birkelbot/Lockout/README.md

# BirkelBot Battlebot Repo
This repository is for the code related to Matt Birkel's Battlebot for the Combotics competition held annually at the University of Illinois at Urbana Champaign

### Folder Structure
* Robot - This is robot side code. For now this should largely be arduino code for the arduino on board the robot.
* DriverStation - This is the operator side code. This is the code that runs on a driverstation computer.
* Arduino_Calibration_Stuff - This is a folder for a tool to use the arduino to calibrate ESC's

### Dependencies
The Robot code is written for an Arduino Pro Mini. As such the Arduino IDE is required to compile and upload the Arduino-side code. The Arduino IDE offers a variety of Libraries for use. This project utilizes

* Encoder by Paul Stoffregen (version 1.4.1)
* PID by Brett Beauregard (version 1.2.0)

To install these libraries

- Go to 'Sketch' -> 'Include Library' -> 'Manage Libraries...'
- Search '<package-name>'
- Install '<package-name>'
