birkelbot/Lockout/PCB_files/Dumptruck2020.brd

## EAGLE design PCB_files/Dumptruck2020.brd (2020-02-21)

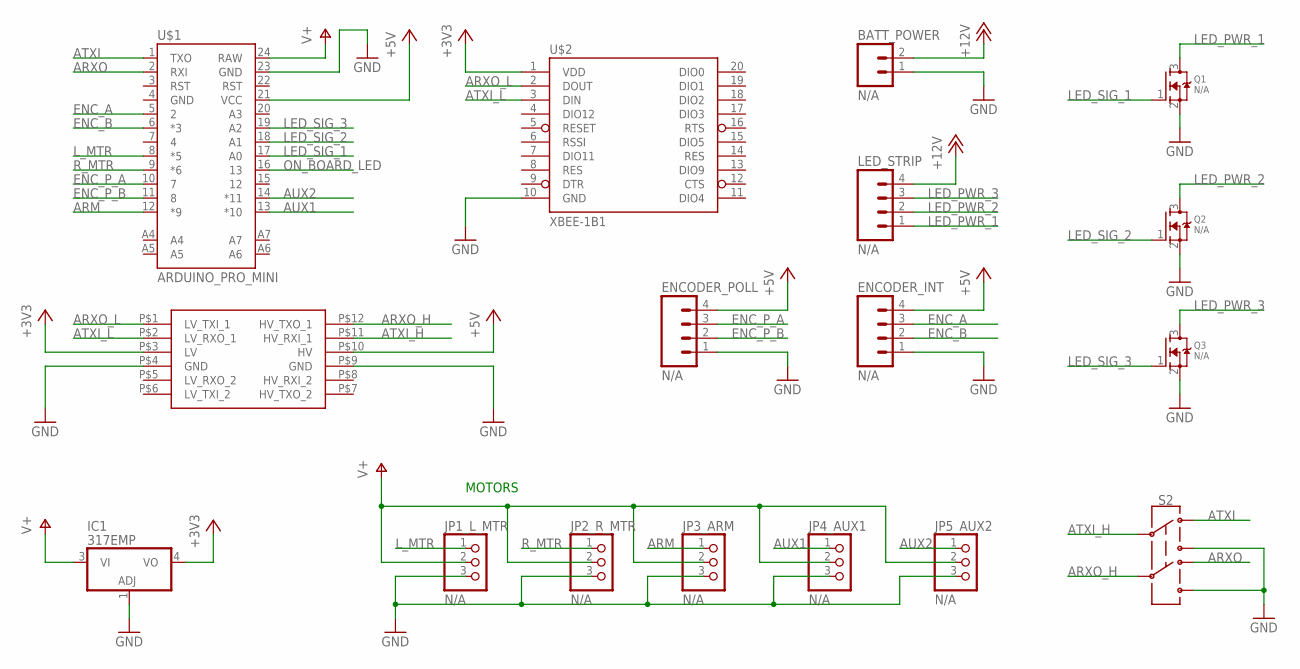
[picture p1: schematic Dumptruck2020.sch]

Parts:
BATT_POWER: N/A; 1X02
ENCODER_INT: N/A; 1X04_LOCK
ENCODER_POLL: N/A; 1X04_LOCK
IC1: 317EMP; SOT223
JP1_L_MTR, JP2_R_MTR, JP3_ARM, JP4_AUX1, JP5_AUX2: N/A; 1X03
LED_STRIP: N/A; 1X04_LOCK
Q1, Q2, Q3: N/A; SOT23
S2: SWITCH-DPDT-SMD-AYZ0202; SWITCH_DPDT_SMD_AYZ0202
U$1: ARDUINO_PRO_MINI
U$2: XBEE-1B1; XBEE-1
U$3: LOGIC_LEVEL_CONVERTER

Connections:
+3V3: IC1.4 (VO), U$2.1 (VDD), U$3.P$3 (LV)
+5V: ENCODER_INT.4, ENCODER_POLL.4, U$1.21 (VCC), U$3.P$10 (HV)
+12V: BATT_POWER.2, LED_STRIP.4
ARM: JP3_ARM.1, U$1.12 (*9)
ARXO: S2.4, U$1.2 (RXI)
ARXO_H: S2.5, U$3.P$12 (HV_TXO_1)
ARXO_L: U$2.2 (DOUT), U$3.P$1 (LV_TXI_1)
ATXI: S2.1, U$1.1 (TXO)
ATXI_H: S2.2, U$3.P$11 (HV_RXI_1)
ATXI_L: U$2.3 (DIN), U$3.P$2 (LV_RXO_1)
AUX1: JP4_AUX1.1, U$1.13 (*10)
AUX2: JP5_AUX2.1, U$1.14 (*11)
ENC_A: ENCODER_INT.3, U$1.5 (2)
ENC_B: ENCODER_INT.2, U$1.6 (*3)
ENC_P_A: ENCODER_POLL.3, U$1.10 (7)
ENC_P_B: ENCODER_POLL.2, U$1.11 (8)
GND: BATT_POWER.1, ENCODER_INT.1, ENCODER_POLL.1, IC1.1 (ADJ), JP1_L_MTR.3, JP2_R_MTR.3, JP3_ARM.3, JP4_AUX1.3, JP5_AUX2.3, Q1.2 (S), Q2.2 (S), Q3.2 (S), S2.3, S2.6, U$1.23 (GND), U$2.10 (GND), U$3.P$4 (GND), U$3.P$9 (GND)
LED_PWR_1: LED_STRIP.1, Q1.3 (D)
LED_PWR_2: LED_STRIP.2, Q2.3 (D)
LED_PWR_3: LED_STRIP.3, Q3.3 (D)
LED_SIG_1: Q1.1 (G), U$1.17 (A0)
LED_SIG_2: Q2.1 (G), U$1.18 (A1)
LED_SIG_3: Q3.1 (G), U$1.19 (A2)
L_MTR: JP1_L_MTR.1, U$1.8 (*5)
ON_BOARD_LED: U$1.16 (13)
R_MTR: JP2_R_MTR.1, U$1.9 (*6)
V+: IC1.3 (VI), JP1_L_MTR.2, JP2_R_MTR.2, JP3_ARM.2, JP4_AUX1.2, JP5_AUX2.2, U$1.24 (RAW)

Notes on the sheet:
MOTORS

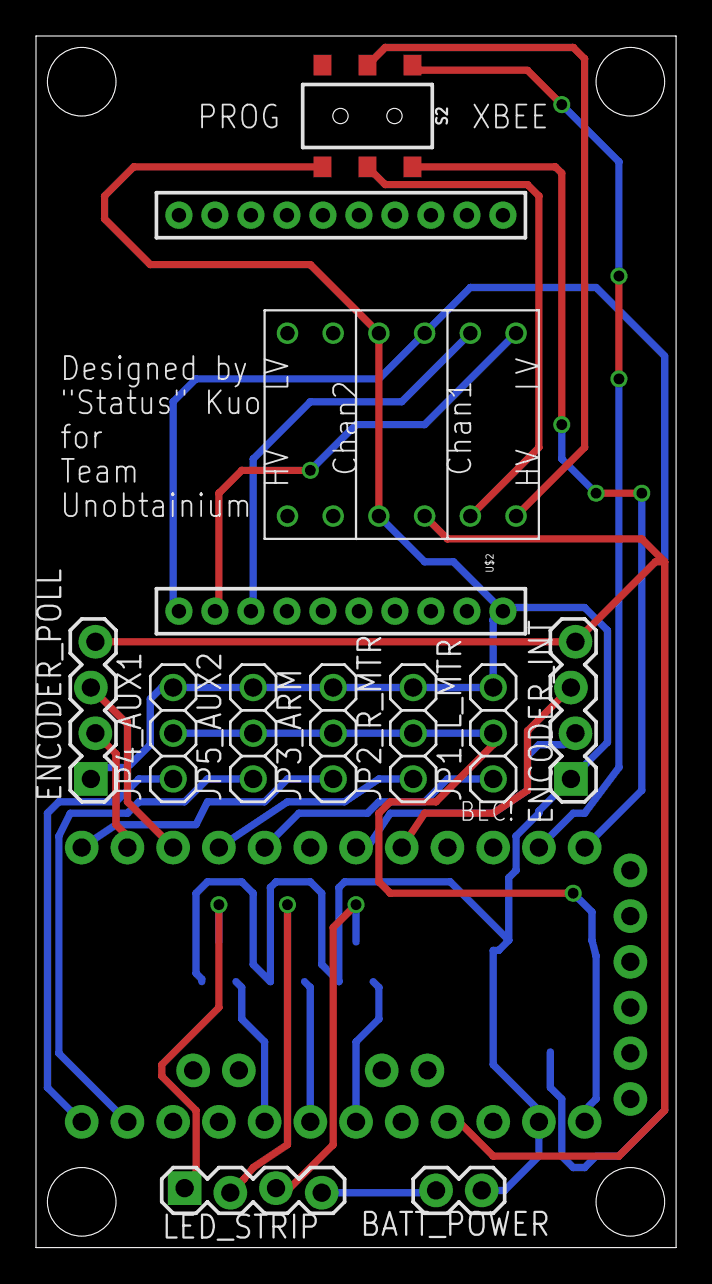
[picture p2: board Dumptruck2020.brd from above]

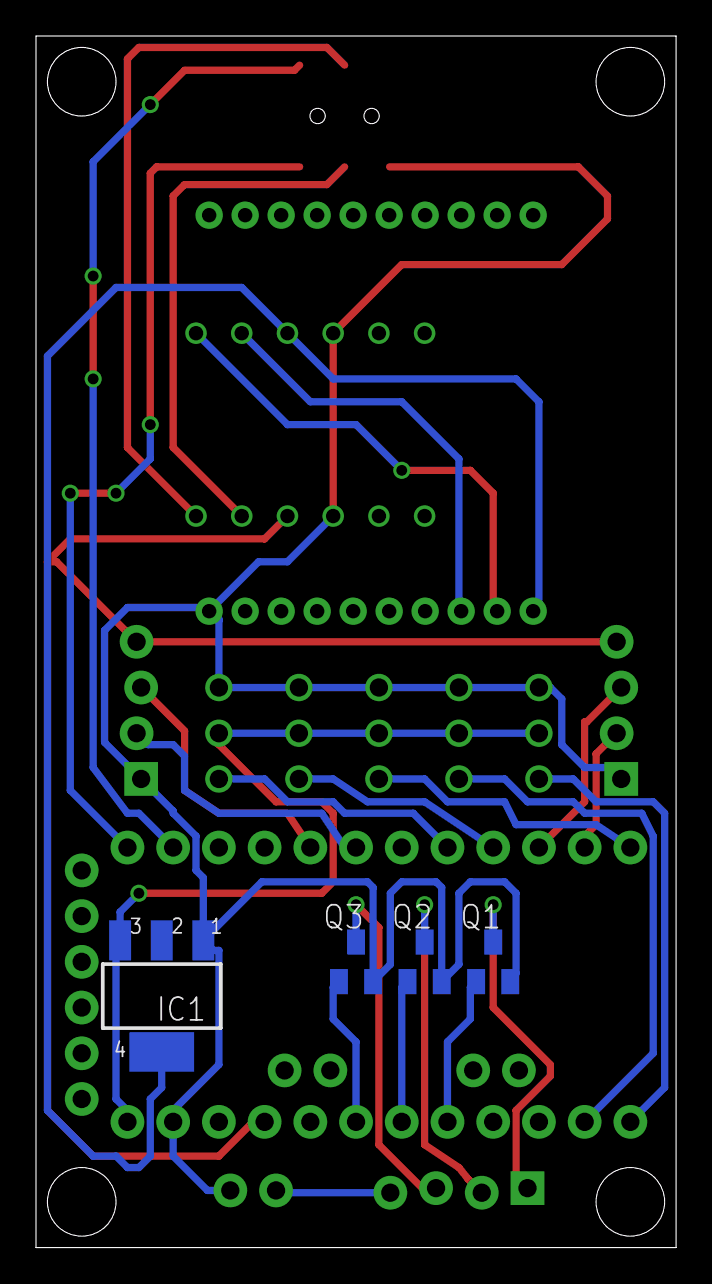
[picture p3: board Dumptruck2020.brd from below]

Board: 2 copper layers, 35.6 x 67.3 mm, 17 parts (4 on the bottom side), 26 nets.
