birkelbot/Lockout/(commit log)

2020-02-06 First commit. Forking from https://github.com/birkelbot/Wall-F_2019.git
    [Dumptruck2018.brd, Dumptruck2018.sch]
2020-02-06 Removed all the PID-related logic. After testing using PID in the 2019 season, I decided it wasn't useful/reliable enough to continue using it. The new version of the robot does not have an encoder, 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
2020-02-21 Adding 2020 New PCB Files
    This commit adds the new 2020 Eagle files for the
    "Controls" board. Features a new switch.
    [Dumptruck2020.brd, Dumptruck2020.sch]
2020-02-22 Updates to make it work with Python 3. Also updated the local test to be enabled/disabled using a macro rather than having to comment out huge blocks of Arduino code. Also some minor tunings to the d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
2021-10-06 Added basic pygame UI to allow use of Bluetooth controllers. Pygame will only process bluetooth controllers when the game is the 'active' window, and there was previosly no game window rendered for t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
2022-02-17 Added forward declarations of functions in Arduino code
2022-02-17 Added ability to use bumpers as a way to slowly move the arm up/down at a fixed command -- good for lowering the arm back to the ground in a more controlled manner
    [DriverStation.py]
2022-02-17 Fix a bug with the scale factor calculation in arcadeDrive
    [DriverStation.py]
2023-02-15 Added ability for using dual analog trigger input for arm control
2023-02-15 Added initialization for dual analog triggers for arm control
2023-02-15 Debugging getArmRawFromDualAnalog and fixing channel numbers for running on RPi
    [DriverStation.py]
2023-02-15 Added a button listener script for running the driver station by pushing the button on the Pi Case 40
2023-02-15 Added a bash launcher script for ButtonListener.py
2023-03-30 Set up right bumper as an 'arm turbo' button, and set the default arm commands to be lower power. Also updated the drive to be more sensitive now that I have the tall joysticks installed on the Xbox 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
2023-03-30 Accidentally removed the yNeg and rNeg from the arcadeDrive's calculation of motor commends. Restoring.
2023-03-30 Removed a debugging print line
2024-12-15 Tweaks made directly on driver station RPi at competitions from 2022
2025-04-03 Un-inverting the left joystick for drive. I'm using the old PCB, and for some reason it's different than what was previously working for the new PCB, not sure why.
    [DriverStation.py]
2025-04-03 Adding a tunable turning correction to help the robot drive straight
    [DriverStation.py]
2025-04-03 Re-inverting the L joystick for drive (I realized I had the PWM wires flip-flopped on the old PCB, which is why it was backwards before); also un-invert the R drive motor (I realized that the ESCs do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
    [ArduinoProMini.ino, DriverStation.py]
2025-04-05 Re-introducing the 'arm up slow' button on the right bumper, and moving 'arm turbo' to the 'A' button. I want 'arm up slow' so that I can get over the lifted floor panels more easily.
2025-05-25 Moving HelloWorld.ino into its own subfolder because the Arduino IDE is opening all .ino files in the same directory and trying to compile them together as one sketch. This obviously breaks because I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
